7m4mon/ook_uhf_transceiver/(commit log)

2024-02-18 写真を差し替え
2024-02-20 解説動画を追加
